ilyas-asmouki/IRIS_HW/Encoders/Docs/FrontPCB.png

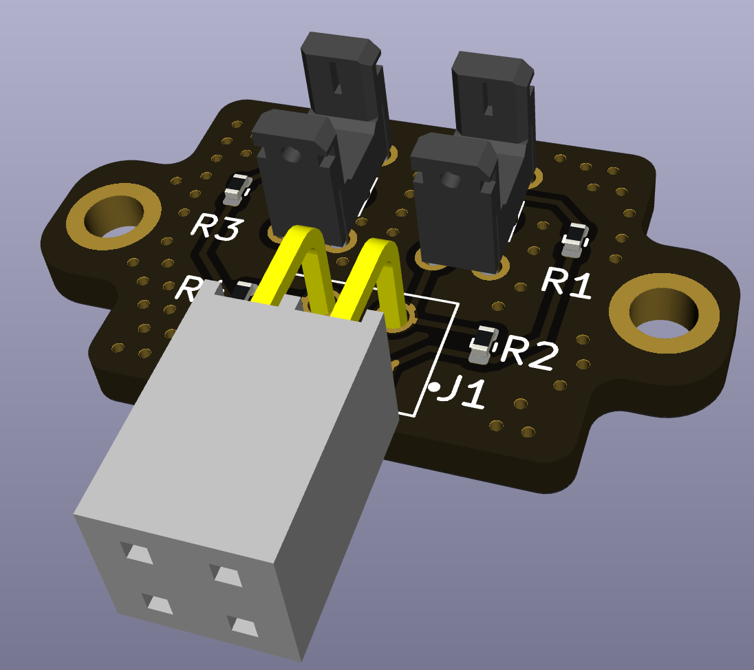
Encoders/Docs/FrontPCB.png
