ilyas-asmouki/IRIS_HW/Encoders/Docs/BackPCB.png

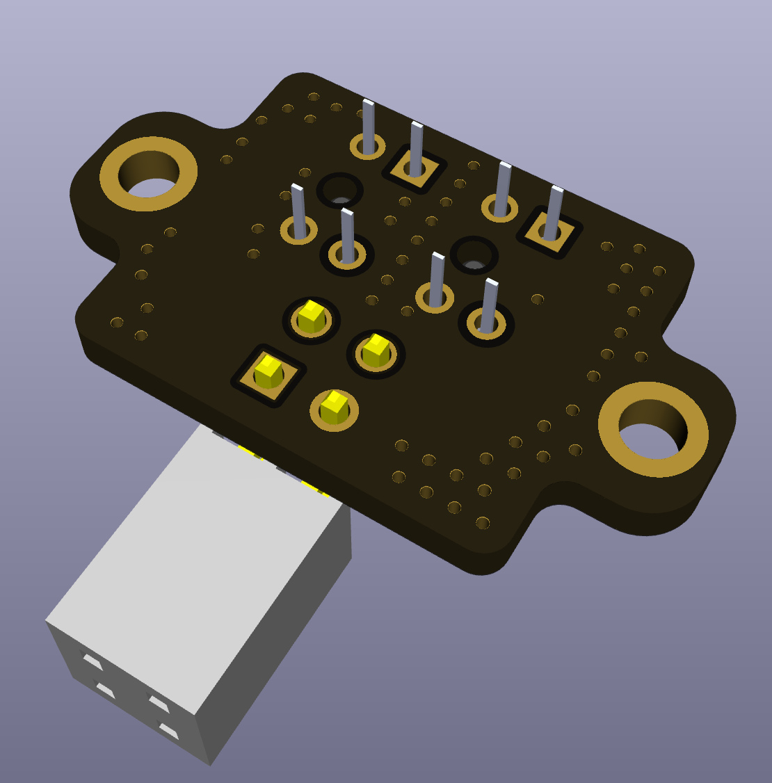
Encoders/Docs/BackPCB.png
