ilyas-asmouki/IRIS_HW/Encoders/Docs/Back.png

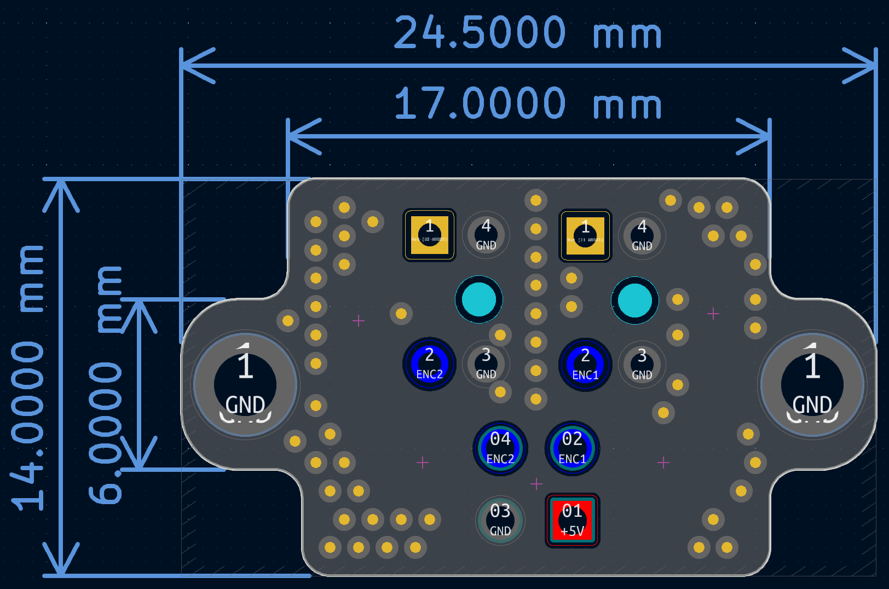
Encoders/Docs/Back.png
