ilyas-asmouki/IRIS_HW/Encoders/Docs/Front.png

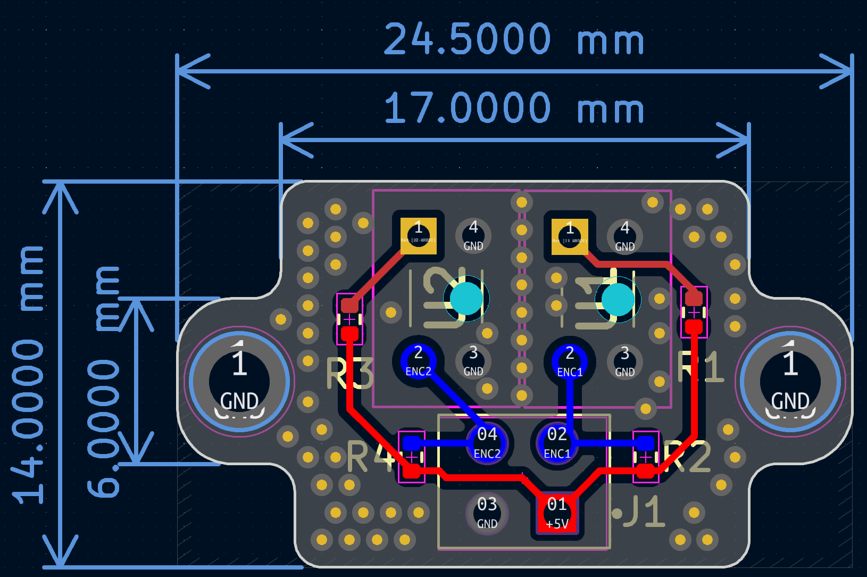
Encoders/Docs/Front.png
