ilyas-asmouki/IRIS_HW/Motor Control Hub/Docs/Back.png

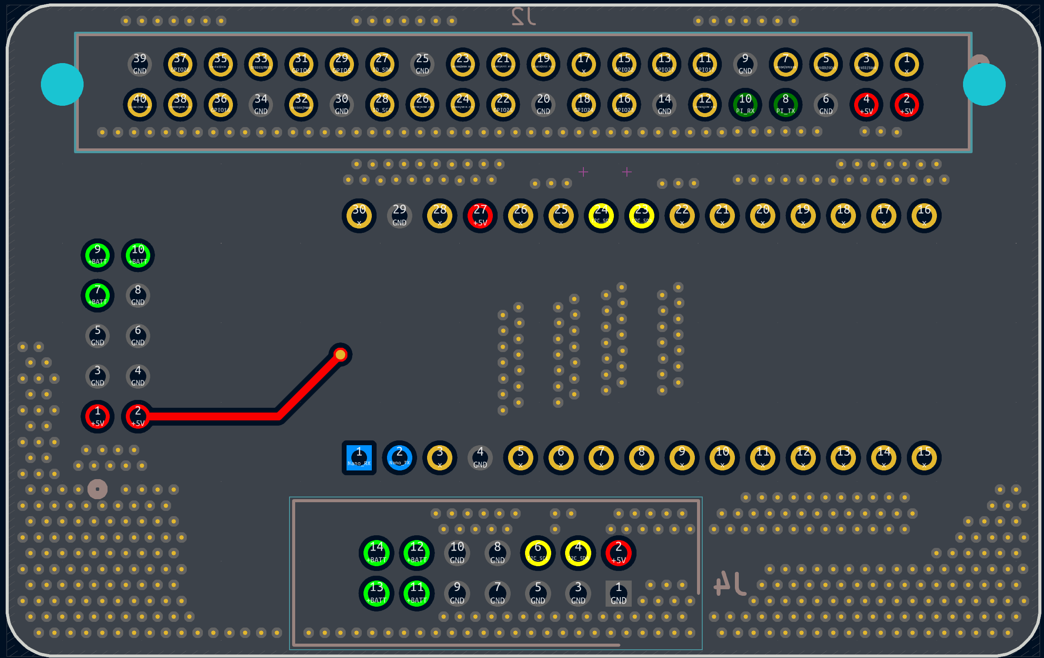
Motor Control Hub/Docs/Back.png
