ilyas-asmouki/IRIS_HW/Motor Control Hub/Docs/BackPCB.png

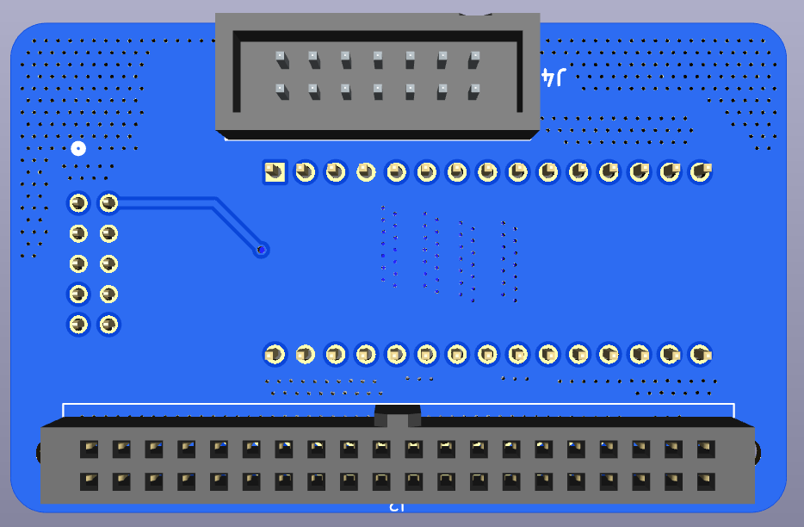
Motor Control Hub/Docs/BackPCB.png
