ilyas-asmouki/IRIS_HW/Motor Control Hub/Docs/Front.png

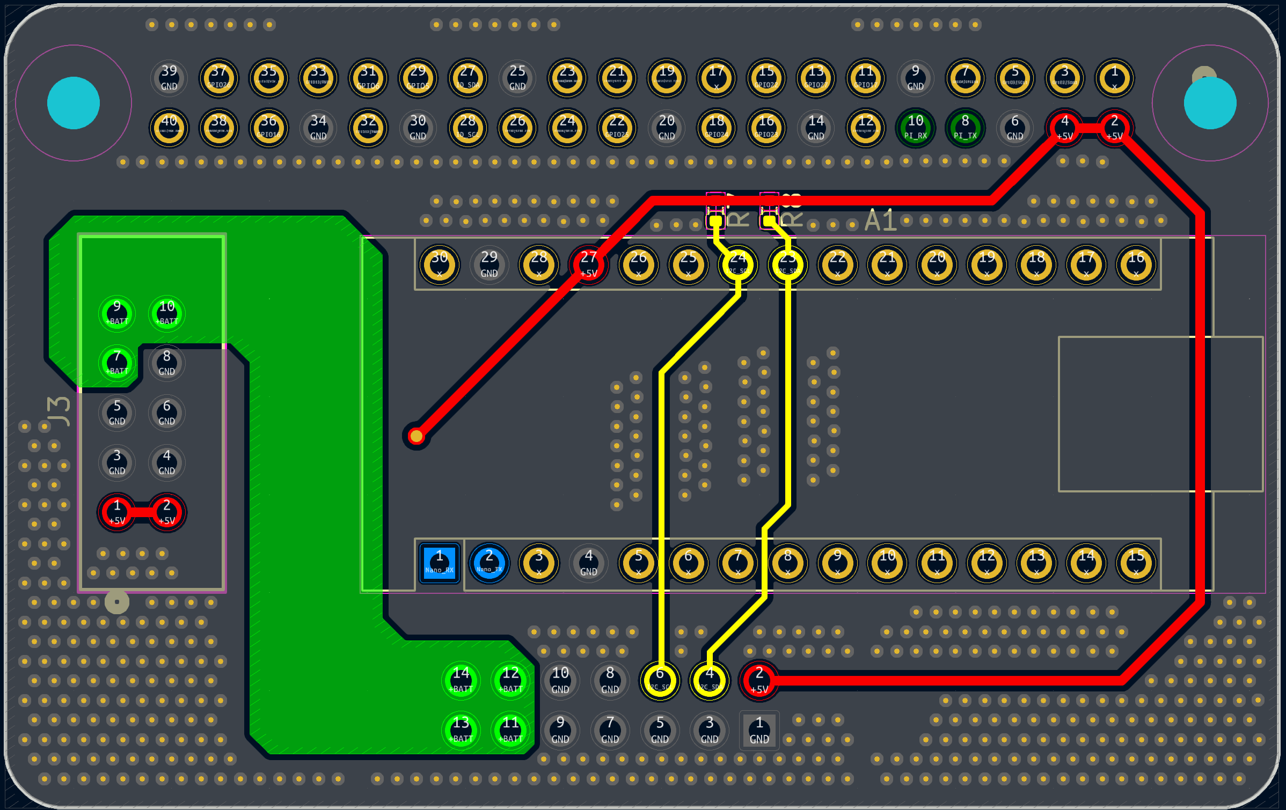
Motor Control Hub/Docs/Front.png
