ilyas-asmouki/IRIS_HW/Motor Control Hub/Docs/FrontPCB.png

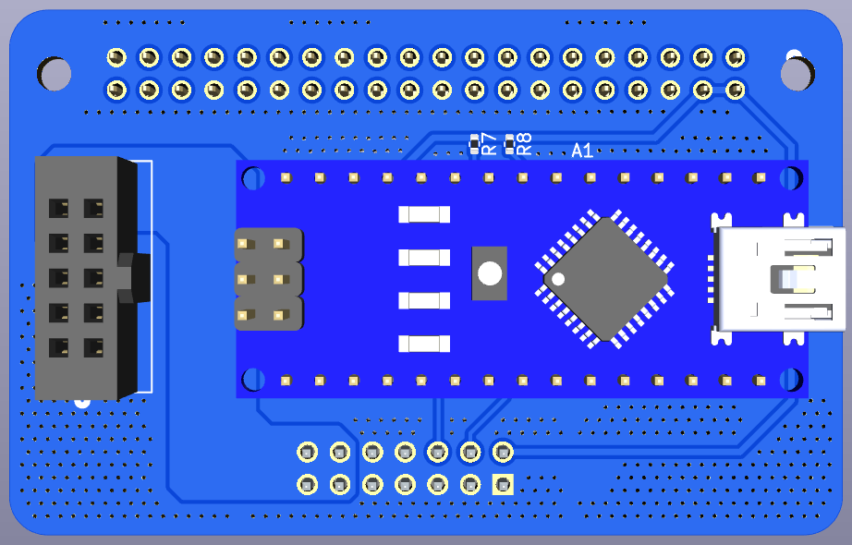
Motor Control Hub/Docs/FrontPCB.png
