ilyas-asmouki/IRIS_HW/Power Supply/Docs/Back.png

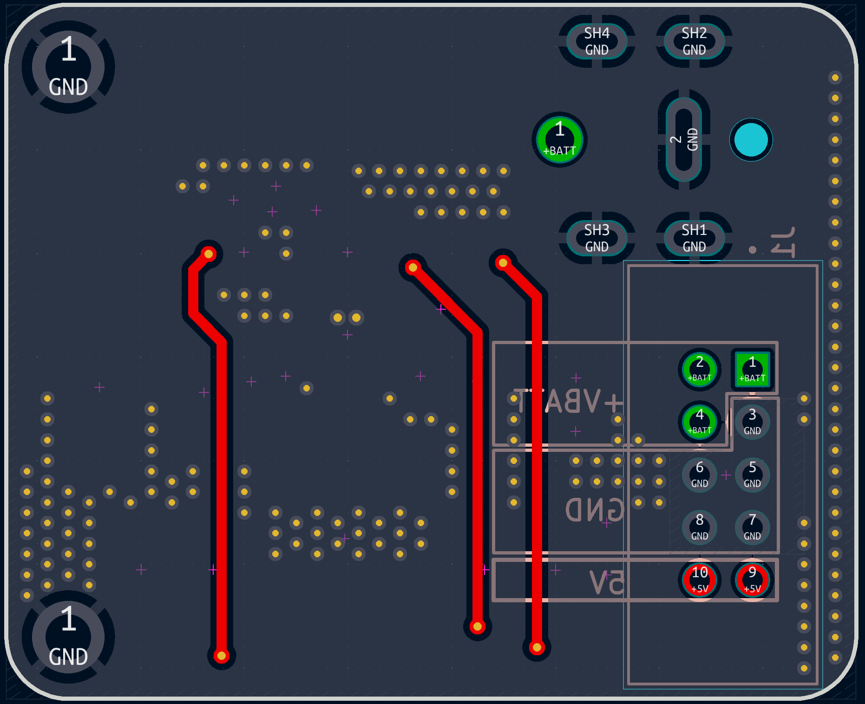
Power Supply/Docs/Back.png
