ilyas-asmouki/IRIS_HW/Power Supply/Docs/BackPCB.png

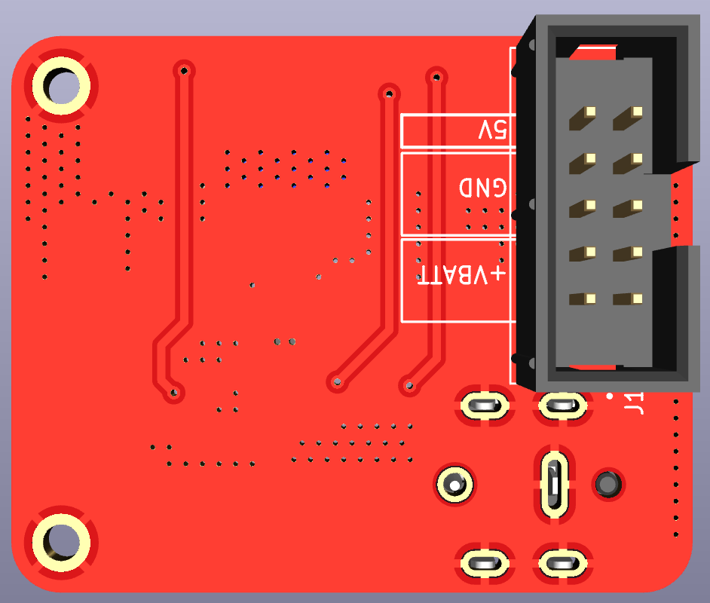
Power Supply/Docs/BackPCB.png
