ilyas-asmouki/IRIS_HW/Power Supply/Docs/Front.png

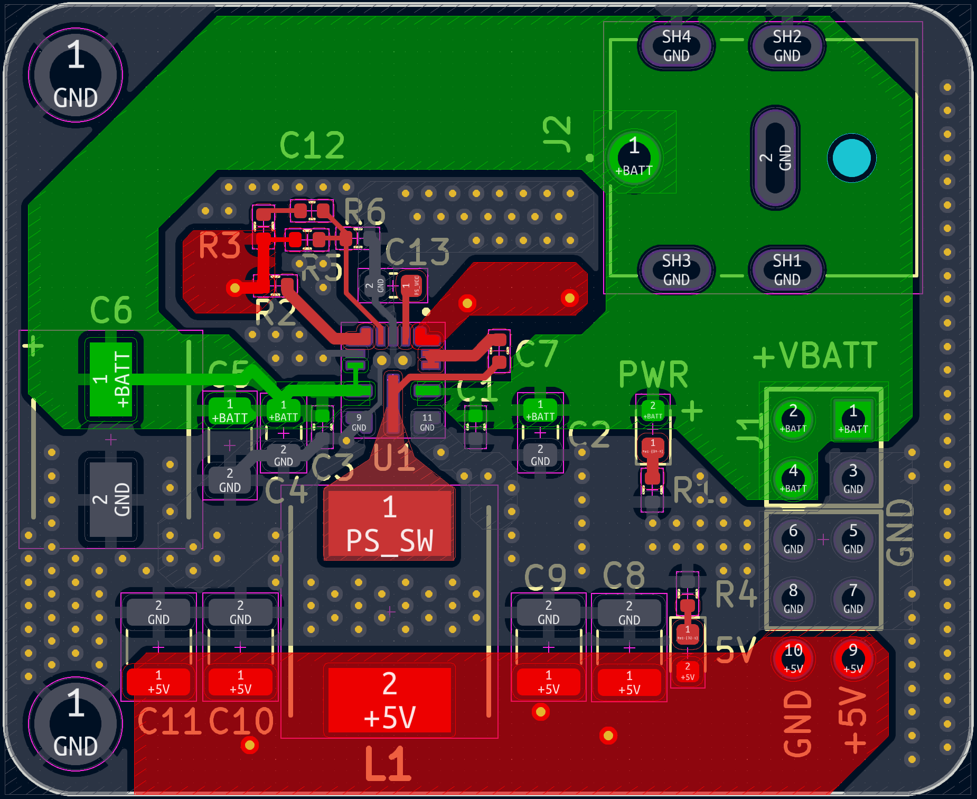
Power Supply/Docs/Front.png
