ilyas-asmouki/IRIS_HW/Power Supply/Docs/FrontPCB.png

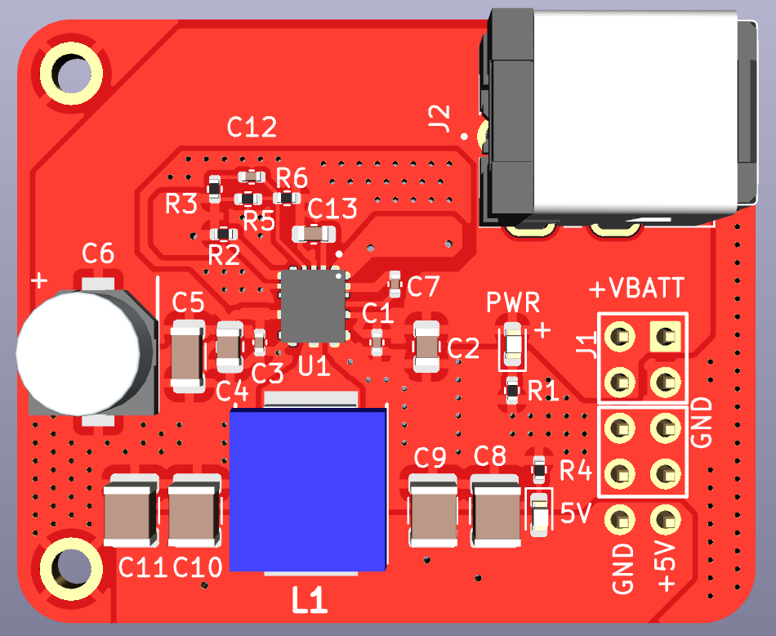
Power Supply/Docs/FrontPCB.png
