ilyas-asmouki/IRIS_HW/Encoders/Docs/Encoders.pdf

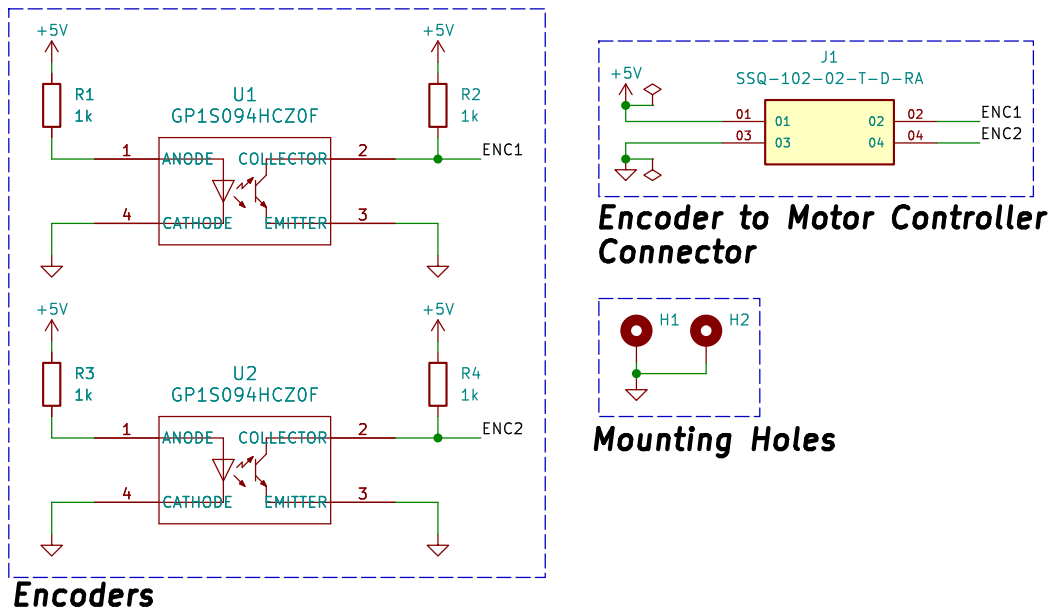
[picture p13: page 1]

Encoder to Motor Controller
Connector
