ilyas-asmouki/IRIS_HW/Motor Control Hub/Docs/Motor Control Hub.pdf

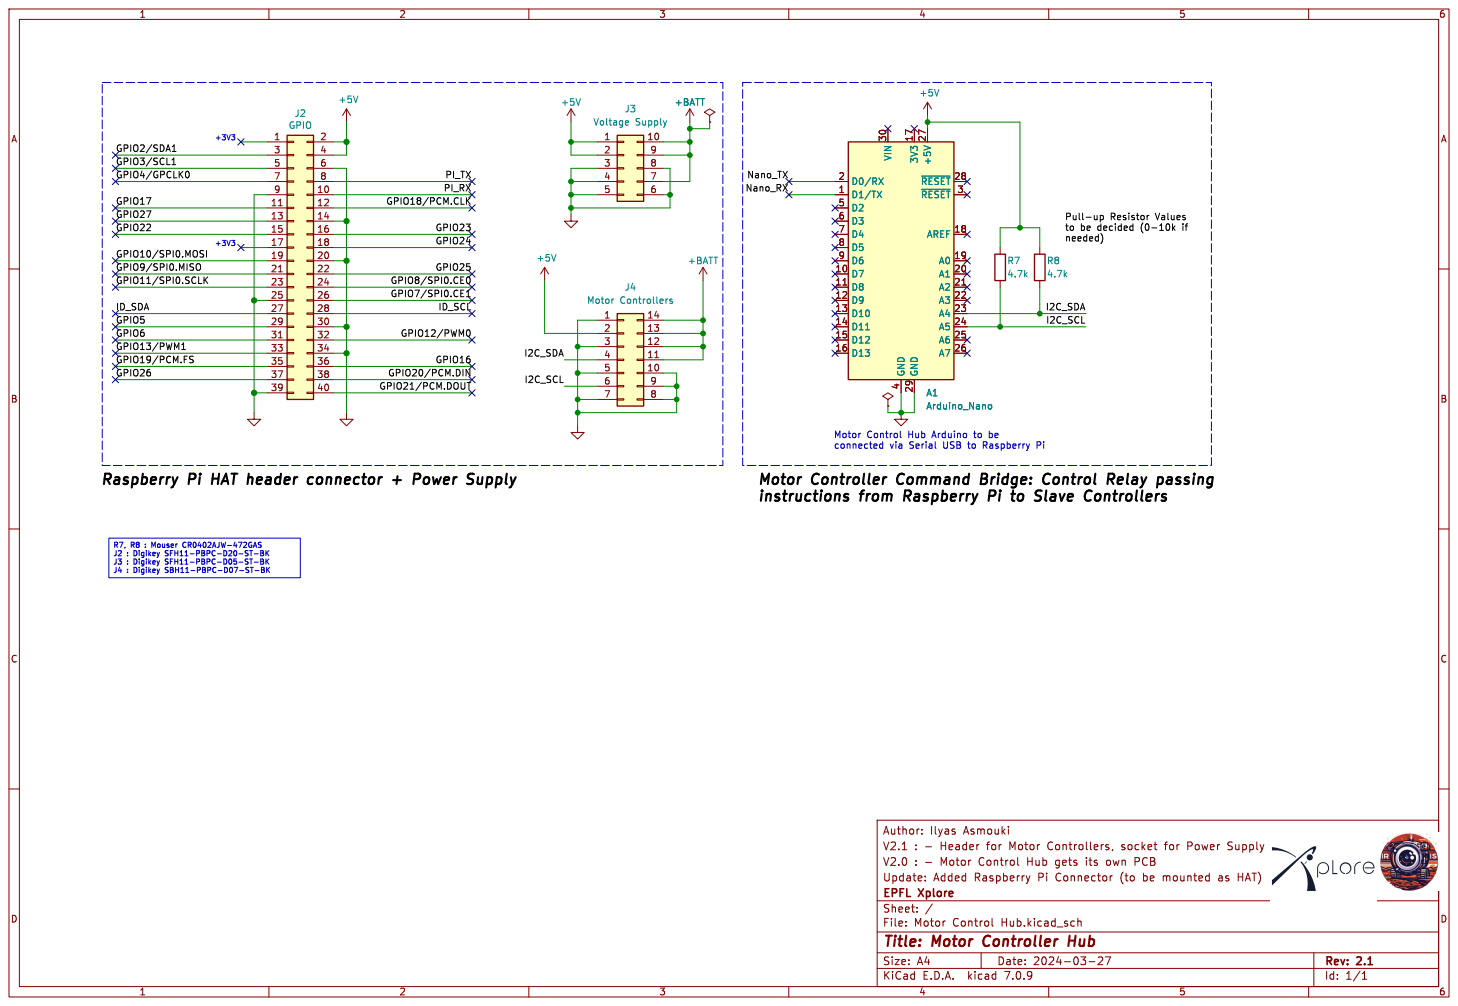
[picture p14: page 1]

I2C_SCL GPIO13/PWM1 GPIO19/PCM.FS GPIO11/SPI0.SCLK GPIO9/SPI0.MISO

Motor Control Hub Arduino to be

instructions from Raspberry Pi to Slave Controllers

J2 : Digikey SFH11-PBPC-D20-ST-BK
J3 : Digikey SFH11-PBPC-D05-ST-BK
J4 : Digikey SBH11-PBPC-D07-ST-BK

Id: 1/1 Title: Motor Controller Hub
