ilyas-asmouki/IRIS_HW/Power Supply/Docs/Power Supply.pdf

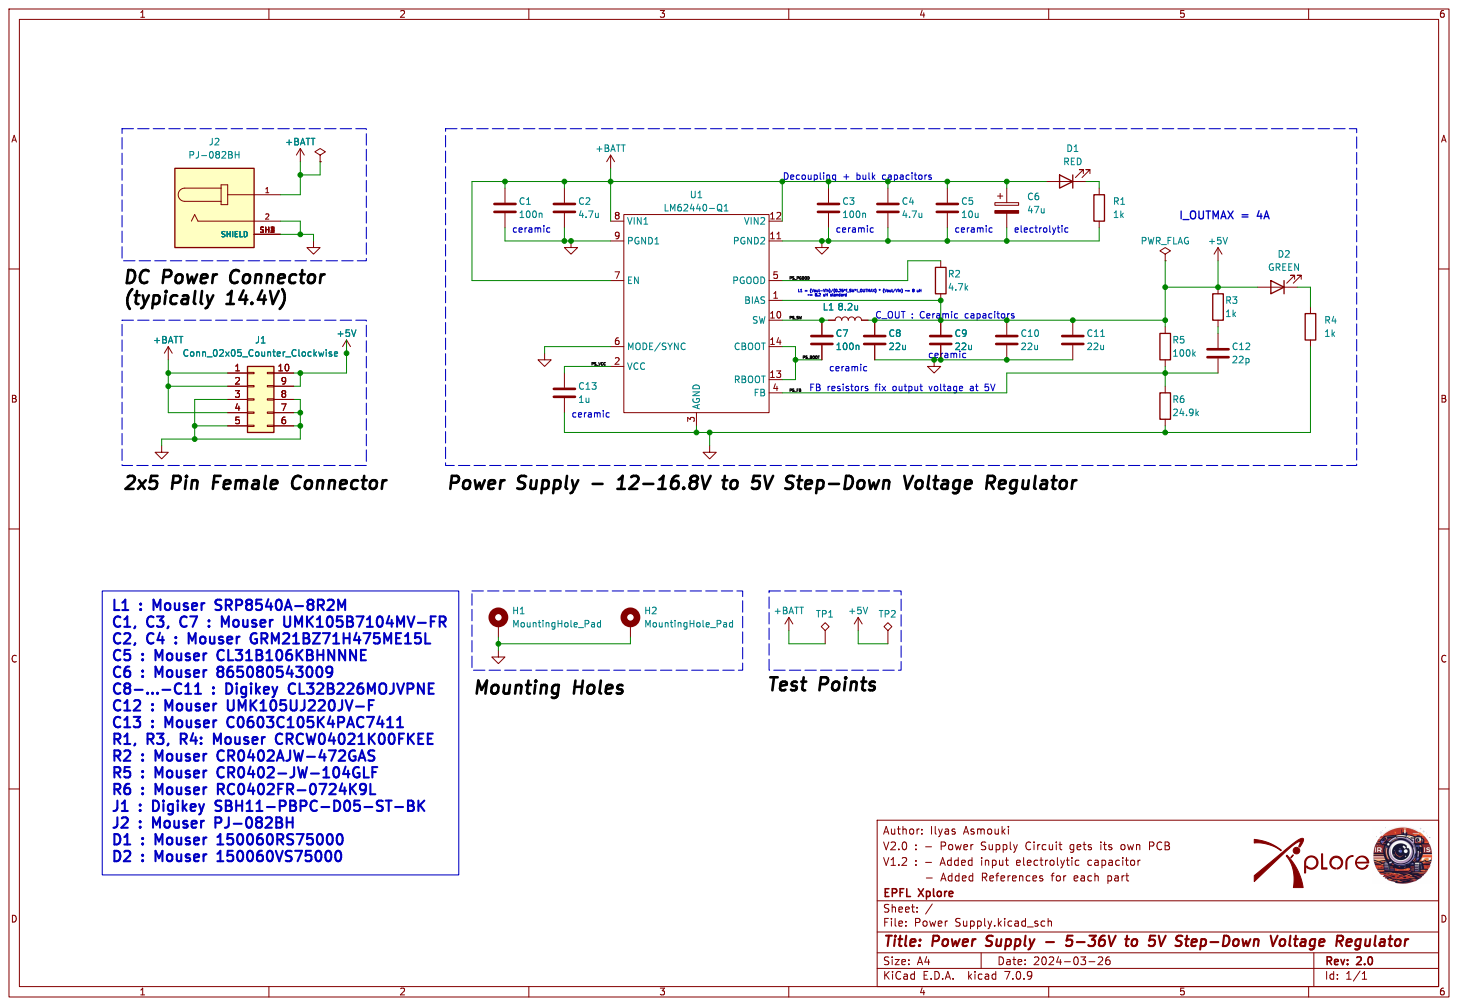
[picture p15: page 1]

3 FB 4 PGOOD 5 MODE/SYNC 6 EN 7 VIN1 8 PGND1 9 U1

ceramic 2x5 Pin Female Connector
