ilyas-asmouki/IRIS_HW/Power Supply/Kicad/Power Supply.kicad_pcb

## KiCad design Power Supply/Kicad/Power Supply.kicad_pcb (2024-05-07)

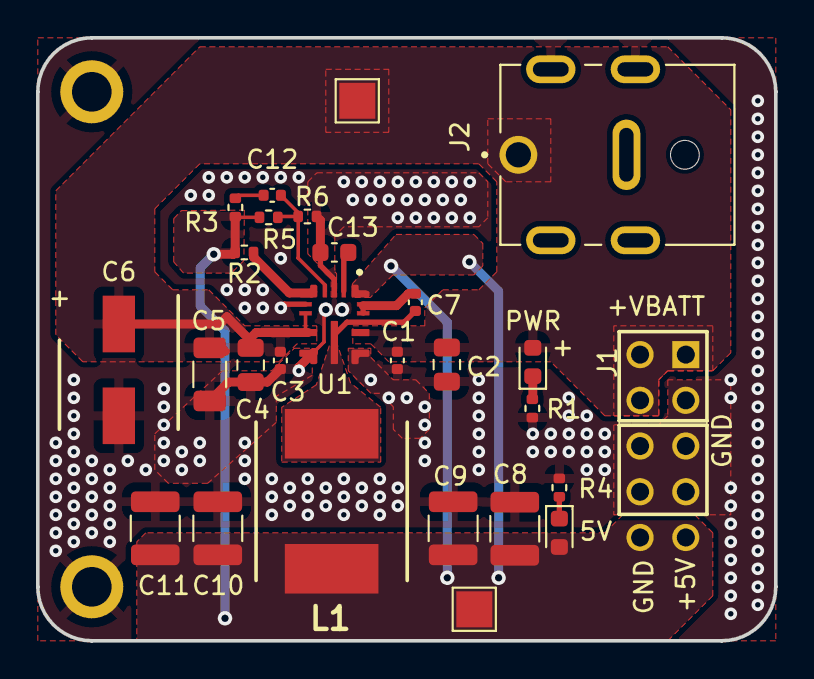
[picture p16: board Power Supply.kicad_pcb from above]

Board: 2 copper layers, 41.0 x 33.5 mm, 29 parts (1 on the bottom side), 11 nets.

Parts:
C1, C3, C7: 100n; C_0402_1005Metric
C2, C4: 4.7u; C_0805_2012Metric
C5: 10u; C_1206_3216Metric
C6: 47u; CAPAE660X550N
C8, C9, C10, C11: 22u; C_1210_3225Metric
C12: 22p; C_0402_1005Metric
C13: 1u; C_0603_1608Metric
D1: RED; LED_0603_1608Metric
D2: GREEN; LED_0603_1608Metric
H1, H2: MountingHole_Pad; MountingHole_2.2mm_M2_ISO7380_Pad
J1: Conn_02x05_Counter_Clockwise; SULLINS_SBH11-PBPC-D05-ST-BK
J2: PJ-082BH; CUI_PJ-082BH
L1: 8.2u; INDPM8884X400N
R1, R3, R4: 1k; R_0402_1005Metric
R2: 4.7k; R_0402_1005Metric
R5: 100k; R_0402_1005Metric
R6: 24.9k; R_0402_1005Metric
TP1, TP2: TestPoint_Alt; TestPoint_Pad_2.0x2.0mm
U1: LM62440-Q1; IC_LM61460AANRJRR

Connections:
+5V: C8.1, C9.1, C10.1, C11.1, D2.2 (A), J1.9, J1.10, L1.2, R2.2, R3.1, R5.1, TP2.1, U1.1 (BIAS)
+BATT: C1.1, C2.1, C3.1, C4.1, C5.1, C6.1, D1.2 (A), J1.1, J1.2, J1.4, J2.1, TP1.1, U1.7 (EN), U1.8 (VIN1), U1.12 (VIN2)
/PS_BOOT: C7.2, U1.13 (RBOOT), U1.14 (CBOOT)
/PS_FB: C12.2, R5.2, R6.1, U1.4 (FB)
/PS_PGOOD: R2.1, U1.5 (PGOOD)
/PS_SW: C7.1, L1.1, U1.10 (SW)
/PS_VCC: C13.1, U1.2 (VCC)
GND: C1.2, C2.2, C3.2, C4.2, C5.2, C6.2, C8.2, C9.2, C10.2, C11.2, C13.2, H1.1, H2.1, J1.3, J1.5, J1.6, J1.7, J1.8, J2.2, J2.SH1 (SHIELD), J2.SH2 (SHIELD), J2.SH3 (SHIELD), J2.SH4 (SHIELD), R1.2, R4.2, R6.2, U1.3 (AGND), U1.6 (MODE/SYNC), U1.9 (PGND1), U1.11 (PGND2)
unnamed: C12.1, R3.2
unnamed: D1.1 (K), R1.1
unnamed: D2.1 (K), R4.1
