ilyas-asmouki/IRIS_HW/Motor Controllers/KiCad/Motor Controllers.kicad_pcb

## KiCad design Motor Controllers/KiCad/Motor Controllers.kicad_pcb (2024-05-07)

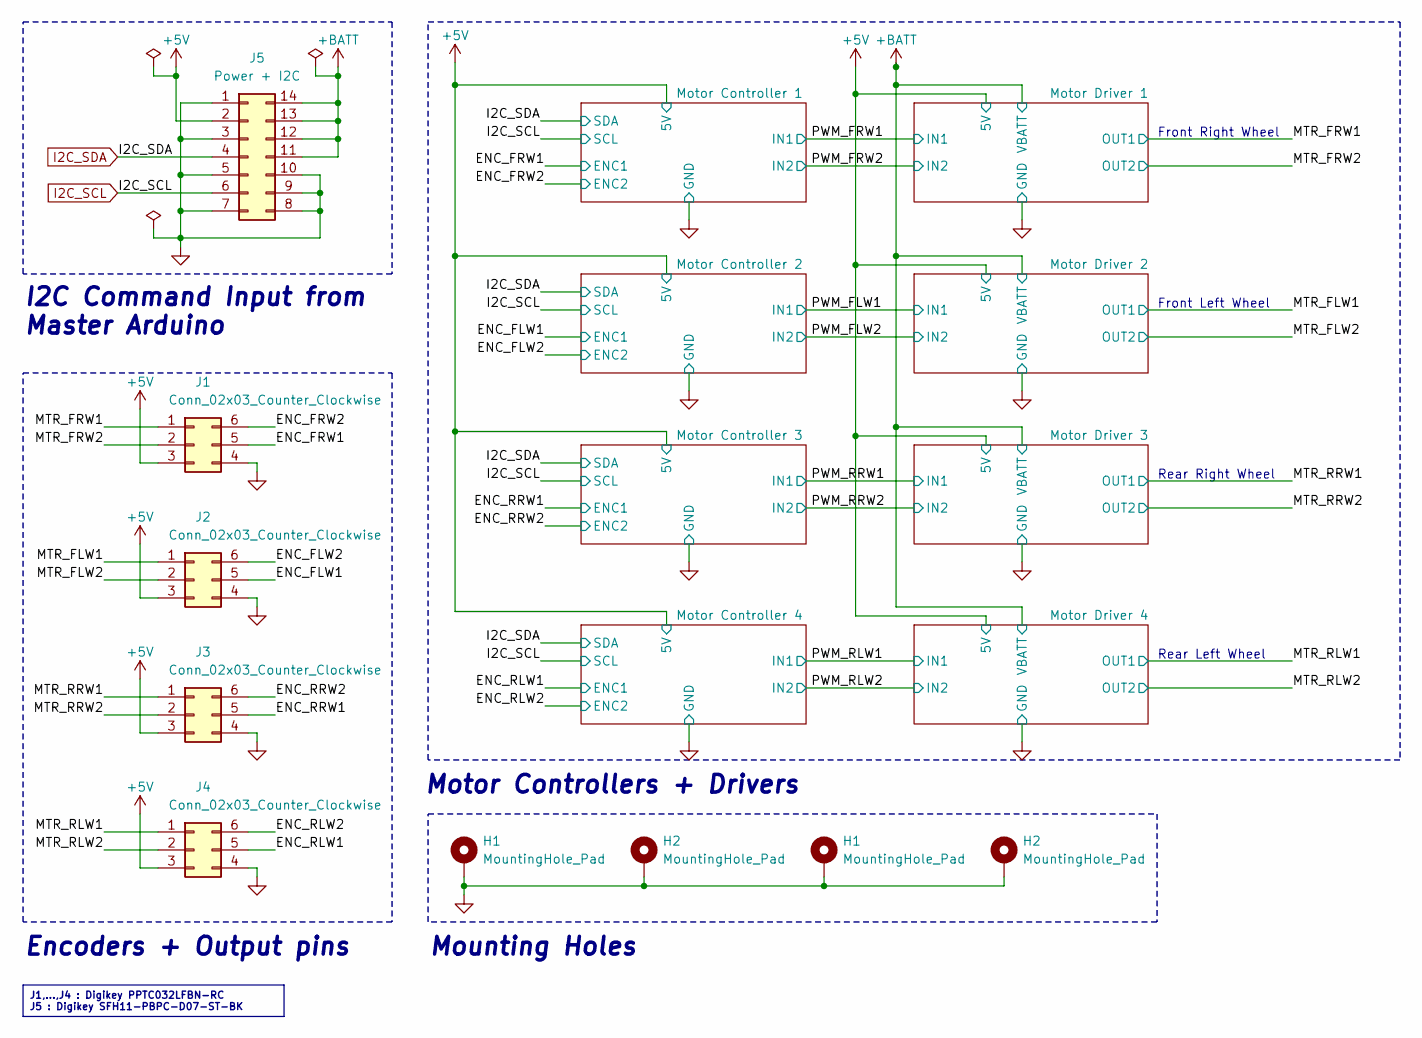
[picture p17: schematic Motor Controllers.kicad_sch]

Parts:
H1, H2: MountingHole_Pad; MountingHole_2.2mm_M2_ISO7380_Pad
J1, J2, J3, J4: Conn_02x03_Counter_Clockwise; SULLINS_PPTC032LFBN-RC
J5: Power + I2C; SULLINS_SFH11-PBPC-D07-ST-BK

Connections:
+5V: J1.3, J2.3, J3.3, J4.3, J5.2; also elsewhere on the board
+BATT: J5.11, J5.12, J5.13, J5.14; also elsewhere on the board
/ENC_FLW1: J2.5; also elsewhere on the board
/ENC_FLW2: J2.6; also elsewhere on the board
/ENC_FRW1: J1.5; also elsewhere on the board
/ENC_FRW2: J1.6; also elsewhere on the board
/ENC_RLW1: J4.5; also elsewhere on the board
/ENC_RLW2: J4.6; also elsewhere on the board
/ENC_RRW1: J3.5; also elsewhere on the board
/ENC_RRW2: J3.6; also elsewhere on the board
/MTR_FLW1: J2.1; also elsewhere on the board
/MTR_FLW2: J2.2; also elsewhere on the board
/MTR_FRW1: J1.1; also elsewhere on the board
/MTR_FRW2: J1.2; also elsewhere on the board
/MTR_RLW1: J4.1; also elsewhere on the board
/MTR_RLW2: J4.2; also elsewhere on the board
/MTR_RRW1: J3.1; also elsewhere on the board
/MTR_RRW2: J3.2; also elsewhere on the board
GND: H1.1, H2.1, J1.4, J2.4, J3.4, J4.4, J5.1, J5.3, J5.5, J5.7, J5.8, J5.9, J5.10; also elsewhere on the board
I2C_SCL: J5.6; also elsewhere on the board
I2C_SDA: J5.4; also elsewhere on the board

Parts of its further copies:
H3, H4: MountingHole_Pad; MountingHole_2.2mm_M2_ISO7380_Pad

Connections of its further copies:
GND: H3.1, H4.1; also elsewhere on the board

Notes on the sheet:
J1,...,J4 : Digikey PPTC032LFBN-RC J5 : Digikey SFH11-PBPC-D07-ST-BK
Mounting Holes
Rear Right Wheel
Rear Left Wheel
I2C Command Input from Master Arduino
Motor Controllers + Drivers
Front Left Wheel
Encoders + Output pins
Front Right Wheel

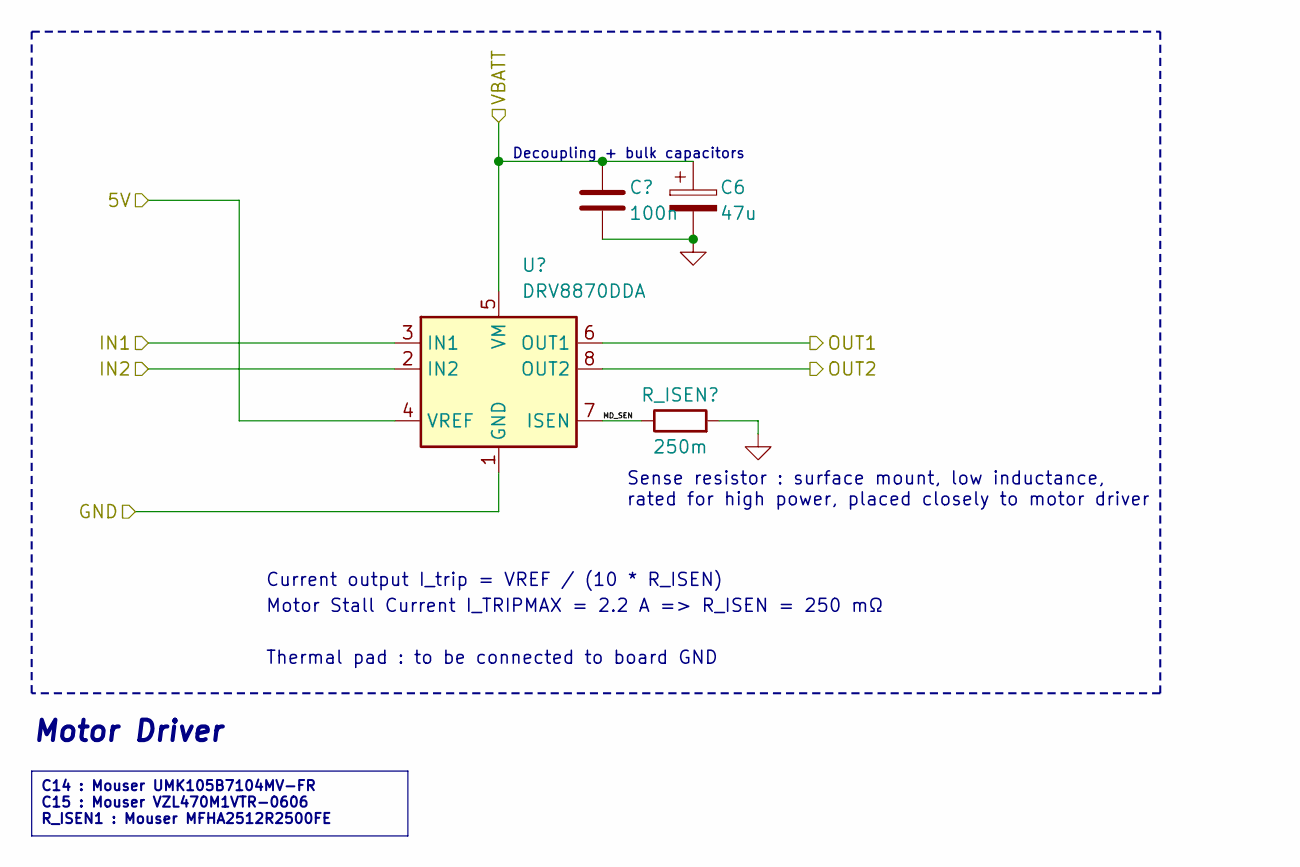
[picture p18: schematic motordriver.kicad_sch]

Parts:
C6: 47u; CAPAE660X550N
C14: 100n; C_0402_1005Metric
R_ISEN1: 250m; R_2512_6332Metric
U2: DRV8870DDA; Texas_HTSOP-8-1EP_3.9x4.9mm_P1.27mm_EP2.95x4.9mm_Mask2.4x3.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

Connections:
+5V: U2.4 (VREF); also elsewhere on the board
+BATT: C14.1, U2.5 (VM); also elsewhere on the board
/MTR_FLW1: U2.6 (OUT1); also elsewhere on the board
/MTR_FLW2: U2.8 (OUT2); also elsewhere on the board
/PWM_FLW1: U2.3 (IN1); also elsewhere on the board
/PWM_FLW2: U2.2 (IN2); also elsewhere on the board
GND: C14.2, R_ISEN1.2, U2.1 (GND), U2.9 (GND); also elsewhere on the board

Parts of its further copies:
C15, C17, C19, C21: 47u; CAPAE660X550N
C16, C18, C20: 100n; C_0402_1005Metric
R_ISEN2, R_ISEN3, R_ISEN4: 250m; R_2512_6332Metric
U1, U3, U4: DRV8870DDA; Texas_HTSOP-8-1EP_3.9x4.9mm_P1.27mm_EP2.95x4.9mm_Mask2.4x3.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

Connections of its further copies:
+5V: U1.4 (VREF), U3.4 (VREF), U4.4 (VREF); also elsewhere on the board
+BATT: C15.1, C16.1, C17.1, C18.1, C19.1, C20.1, C21.1, U1.5 (VM), U3.5 (VM), U4.5 (VM); also elsewhere on the board
/MTR_FRW1: U1.6 (OUT1); also elsewhere on the board
/MTR_FRW2: U1.8 (OUT2); also elsewhere on the board
/MTR_RLW1: U4.6 (OUT1); also elsewhere on the board
/MTR_RLW2: U4.8 (OUT2); also elsewhere on the board
/MTR_RRW1: U3.6 (OUT1); also elsewhere on the board
/MTR_RRW2: U3.8 (OUT2); also elsewhere on the board
/Motor Driver 3/MD_SEN: R_ISEN3.1, U3.7 (ISEN)
/Motor Driver 4/MD_SEN: R_ISEN4.1, U4.7 (ISEN)
/PWM_FRW1: U1.3 (IN1); also elsewhere on the board
/PWM_FRW2: U1.2 (IN2); also elsewhere on the board
/PWM_RLW1: U4.3 (IN1); also elsewhere on the board
/PWM_RLW2: U4.2 (IN2); also elsewhere on the board
/PWM_RRW1: U3.3 (IN1); also elsewhere on the board
/PWM_RRW2: U3.2 (IN2); also elsewhere on the board
GND: C15.2, C16.2, C17.2, C18.2, C19.2, C20.2, C21.2, R_ISEN2.2, R_ISEN3.2, R_ISEN4.2, U1.1 (GND), U1.9 (GND), U3.1 (GND), U3.9 (GND), U4.1 (GND), U4.9 (GND); also elsewhere on the board

Notes on the sheet:
Sense resistor : surface mount, low inductance, rated for high power, placed closely to motor driver
C14 : Mouser UMK105B7104MV-FR C15 : Mouser VZL470M1VTR-0606 R_ISEN1 : Mouser MFHA2512R2500FE
Decoupling + bulk capacitors
Current output I_trip = VREF / (10 * R_ISEN)
Motor Stall Current I_TRIPMAX = 2.2 A => R_ISEN = 250 mΩ
Motor Driver
Thermal pad : to be connected to board GND

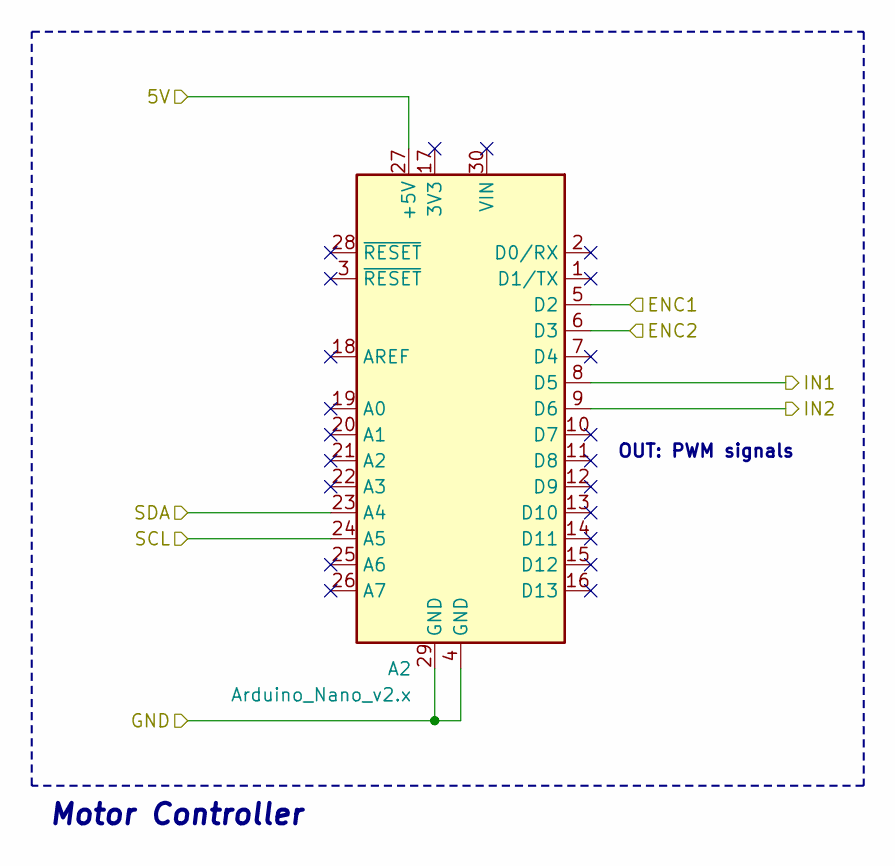
[picture p19: schematic motorcontroller.kicad_sch]

Parts:
A2: Arduino_Nano_v2.x; Arduino_Nano

Connections:
+5V: A2.27 (+5V); also elsewhere on the board
/ENC_FLW1: A2.5 (D2); also elsewhere on the board
/ENC_FLW2: A2.6 (D3); also elsewhere on the board
/PWM_FLW1: A2.8 (D5); also elsewhere on the board
/PWM_FLW2: A2.9 (D6); also elsewhere on the board
GND: A2.4 (GND), A2.29 (GND); also elsewhere on the board
I2C_SCL: A2.24 (A5); also elsewhere on the board
I2C_SDA: A2.23 (A4); also elsewhere on the board

Parts of its further copies:
A1, A3, A4: Arduino_Nano_v2.x; Arduino_Nano

Connections of its further copies:
+5V: A1.27 (+5V), A3.27 (+5V), A4.27 (+5V); also elsewhere on the board
/ENC_FRW1: A1.5 (D2); also elsewhere on the board
/ENC_FRW2: A1.6 (D3); also elsewhere on the board
/ENC_RLW1: A4.5 (D2); also elsewhere on the board
/ENC_RLW2: A4.6 (D3); also elsewhere on the board
/ENC_RRW1: A3.5 (D2); also elsewhere on the board
/ENC_RRW2: A3.6 (D3); also elsewhere on the board
/PWM_FRW1: A1.8 (D5); also elsewhere on the board
/PWM_FRW2: A1.9 (D6); also elsewhere on the board
/PWM_RLW1: A4.8 (D5); also elsewhere on the board
/PWM_RLW2: A4.9 (D6); also elsewhere on the board
/PWM_RRW1: A3.8 (D5); also elsewhere on the board
/PWM_RRW2: A3.9 (D6); also elsewhere on the board
GND: A1.4 (GND), A1.29 (GND), A3.4 (GND), A3.29 (GND), A4.4 (GND), A4.29 (GND); also elsewhere on the board
I2C_SCL: A1.24 (A5), A3.24 (A5), A4.24 (A5); also elsewhere on the board
I2C_SDA: A1.23 (A4), A3.23 (A4), A4.23 (A4); also elsewhere on the board

Notes on the sheet:
Motor Controller
OUT: PWM signals

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
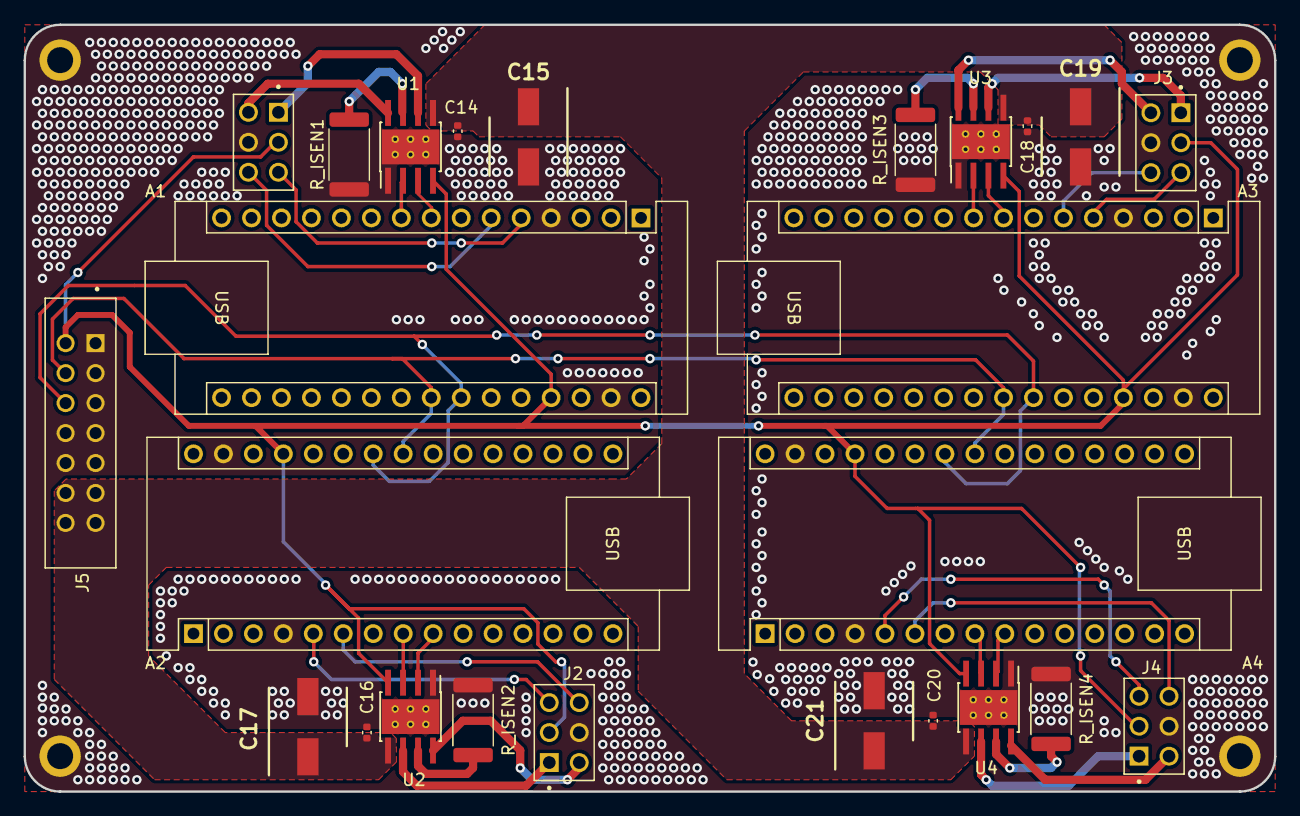
[picture p20: board Motor Controllers.kicad_pcb from above]

Board: 2 copper layers, 106.0 x 65.0 mm, 29 parts (0 on the bottom side), 33 nets.
