ilyas-asmouki/IRIS_HW/Encoders/Kicad/Encoders.kicad_pcb

## KiCad design Encoders/Kicad/Encoders.kicad_pcb (2024-05-07)

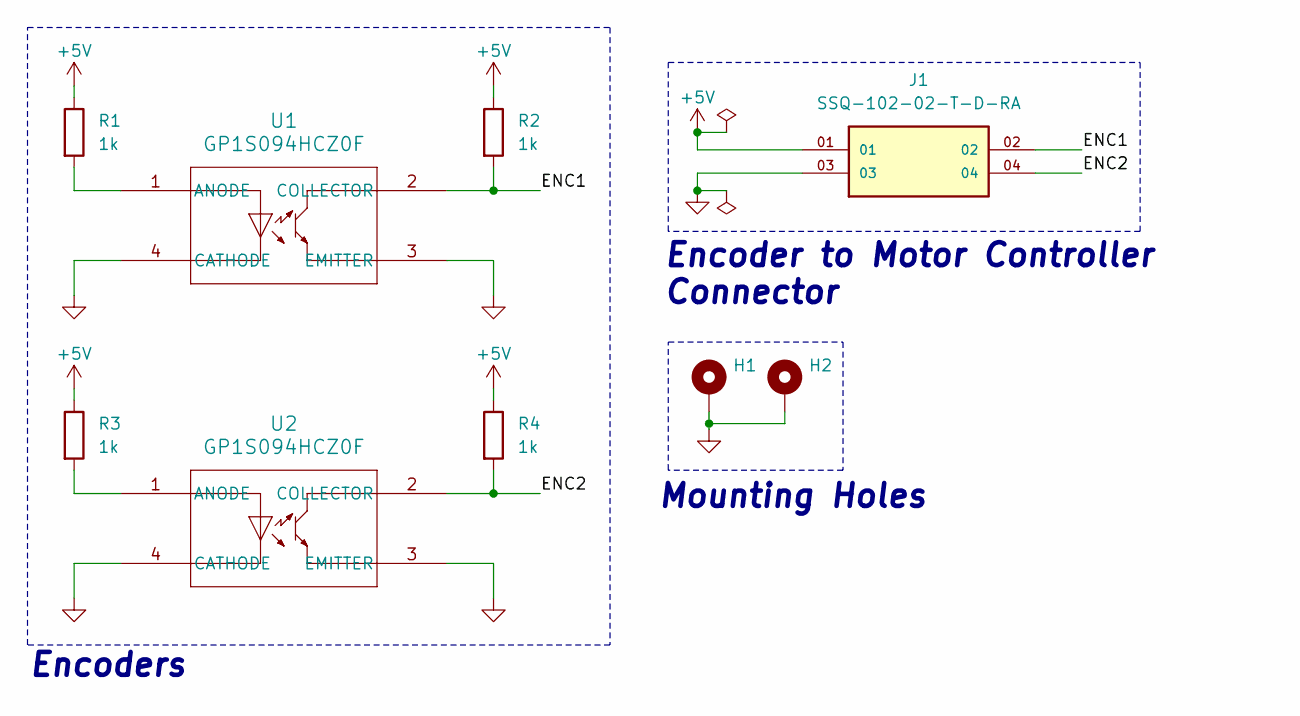
[picture p21: schematic Encoders.kicad_sch]

Parts:
H1, H2: MountingHole_Pad; MountingHole_2.2mm_M2_ISO7380_Pad_TopBottom
J1: SSQ-102-02-T-D-RA; SAMTEC_SSQ-102-02-T-D-RA; PARTREV R
R1, R2, R3, R4: 1k; R_0402_1005Metric
U1, U2: GP1S094HCZ0F

Connections:
+5V: J1.01, R1.1, R2.1, R3.1, R4.1
/ENC1: J1.02, R2.2, U1.2 (COLLECTOR)
/ENC2: J1.04, R4.2, U2.2 (COLLECTOR)
GND: H1.1, H2.1, J1.03, U1.3 (EMITTER), U1.4 (CATHODE), U2.3 (EMITTER), U2.4 (CATHODE)
unnamed: R1.2, U1.1 (ANODE)
unnamed: R3.2, U2.1 (ANODE)

Notes on the sheet:
Encoders
Encoder to Motor Controller Connector
Mounting Holes

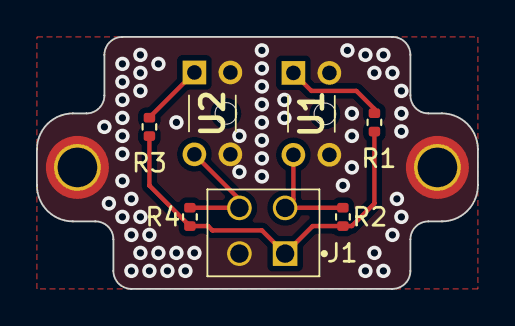
[picture p22: board Encoders.kicad_pcb from above]

Board: 2 copper layers, 24.5 x 14.0 mm, 9 parts (0 on the bottom side), 6 nets.
