ilyas-asmouki/IRIS_HW/Motor Control Hub/KiCad/Motor Control Hub.kicad_pcb

## KiCad design Motor Control Hub/KiCad/Motor Control Hub.kicad_pcb (2024-05-07)

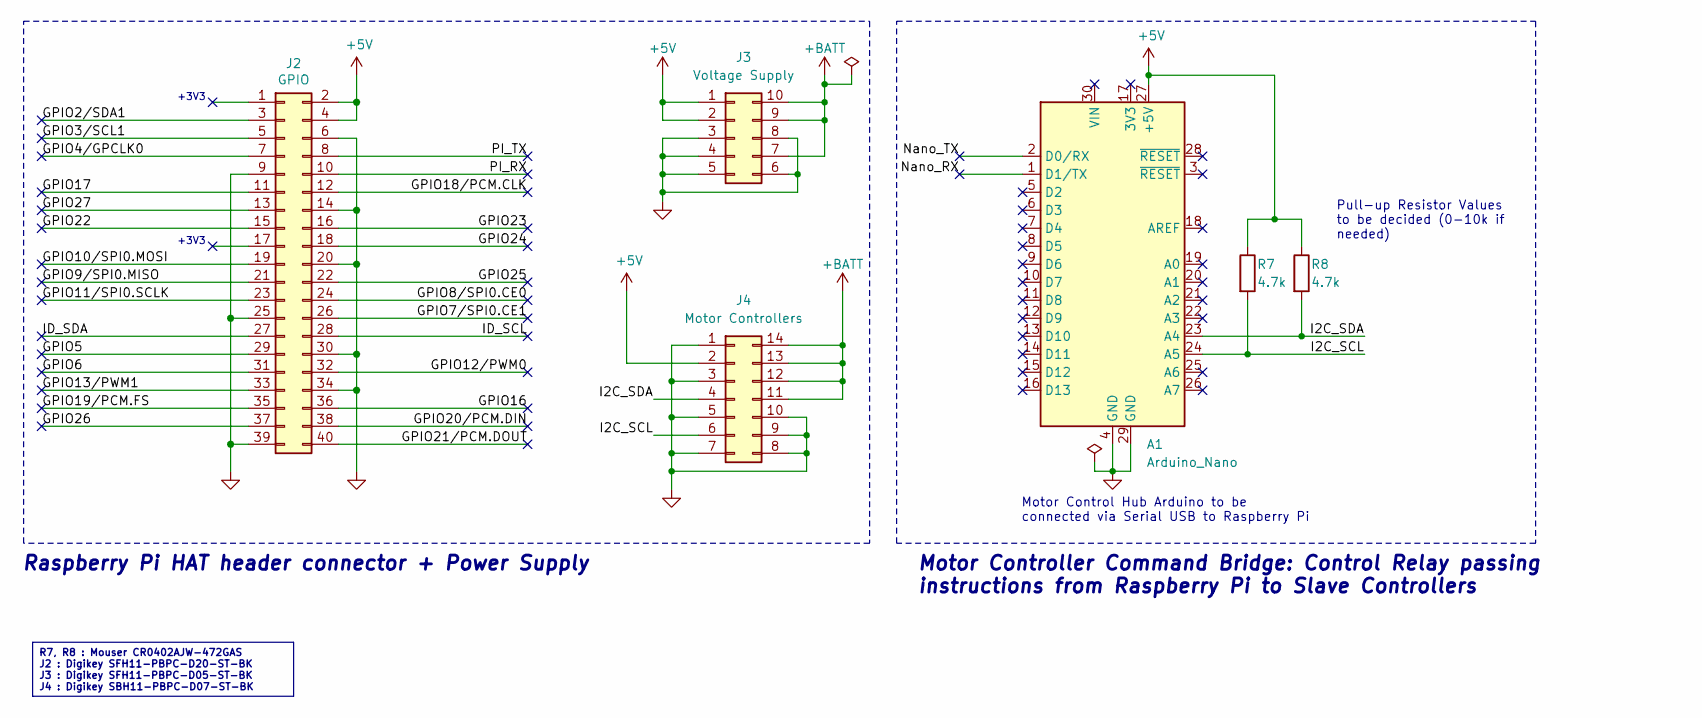
[picture p23: schematic Motor Control Hub.kicad_sch, Motor Controller Hub]

Parts:
A1: Arduino_Nano
J2: GPIO; CONN_SFH11-PBPC-D20-ST-BK_SUL
J3: Voltage Supply; CONN_SFH11-xxxC-D05-ST-XX_SUL
J4: Motor Controllers; SHDR14W64P254_2X7_2528X910X910P
R7, R8: 4.7k; R_0402_1005Metric

Connections:
+5V: A1.27 (+5V), J2.2, J2.4, J3.1, J3.2, J4.2, R7.1, R8.1
+BATT: J3.7, J3.9, J3.10, J4.11, J4.12, J4.13, J4.14
/GPIO2/SDA1: J2.3
/GPIO3/SCL1: J2.5
/GPIO4/GPCLK0: J2.7
/GPIO5: J2.29
/GPIO6: J2.31
/GPIO7/SPI0.CE1: J2.26
/GPIO8/SPI0.CE0: J2.24
/GPIO9/SPI0.MISO: J2.21
/GPIO10/SPI0.MOSI: J2.19
/GPIO11/SPI0.SCLK: J2.23
/GPIO12/PWM0: J2.32
/GPIO13/PWM1: J2.33
/GPIO16: J2.36
/GPIO17: J2.11
/GPIO18/PCM.CLK: J2.12
/GPIO19/PCM.FS: J2.35
/GPIO20/PCM.DIN: J2.38
/GPIO21/PCM.DOUT: J2.40
/GPIO22: J2.15
/GPIO23: J2.16
/GPIO24: J2.18
/GPIO25: J2.22
/GPIO26: J2.37
/GPIO27: J2.13
/I2C_SCL: A1.24 (A5), J4.6, R7.2
/I2C_SDA: A1.23 (A4), J4.4, R8.2
/ID_SCL: J2.28
/ID_SDA: J2.27
/Nano_RX: A1.1 (D1/TX)
/Nano_TX: A1.2 (D0/RX)
/PI_RX: J2.10
/PI_TX: J2.8
GND: A1.4 (GND), A1.29 (GND), J2.6, J2.9, J2.14, J2.20, J2.25, J2.30, J2.34, J2.39, J3.3, J3.4, J3.5, J3.6, J3.8, J4.1, J4.3, J4.5, J4.7, J4.8, J4.9, J4.10

Notes on the sheet:
Motor Control Hub Arduino to be connected via Serial USB to Raspberry Pi
R7, R8 : Mouser CR0402AJW-472GAS J2 : Digikey SFH11-PBPC-D20-ST-BK J3 : Digikey SFH11-PBPC-D05-ST-BK J4 : Digikey SBH11-PBPC-D07-ST-BK
Pull-up Resistor Values to be decided (0-10k if needed)
Motor Controller Command Bridge: Control Relay passing instructions from Raspberry Pi to Slave Controllers
Raspberry Pi HAT header connector + Power Supply
+3V3

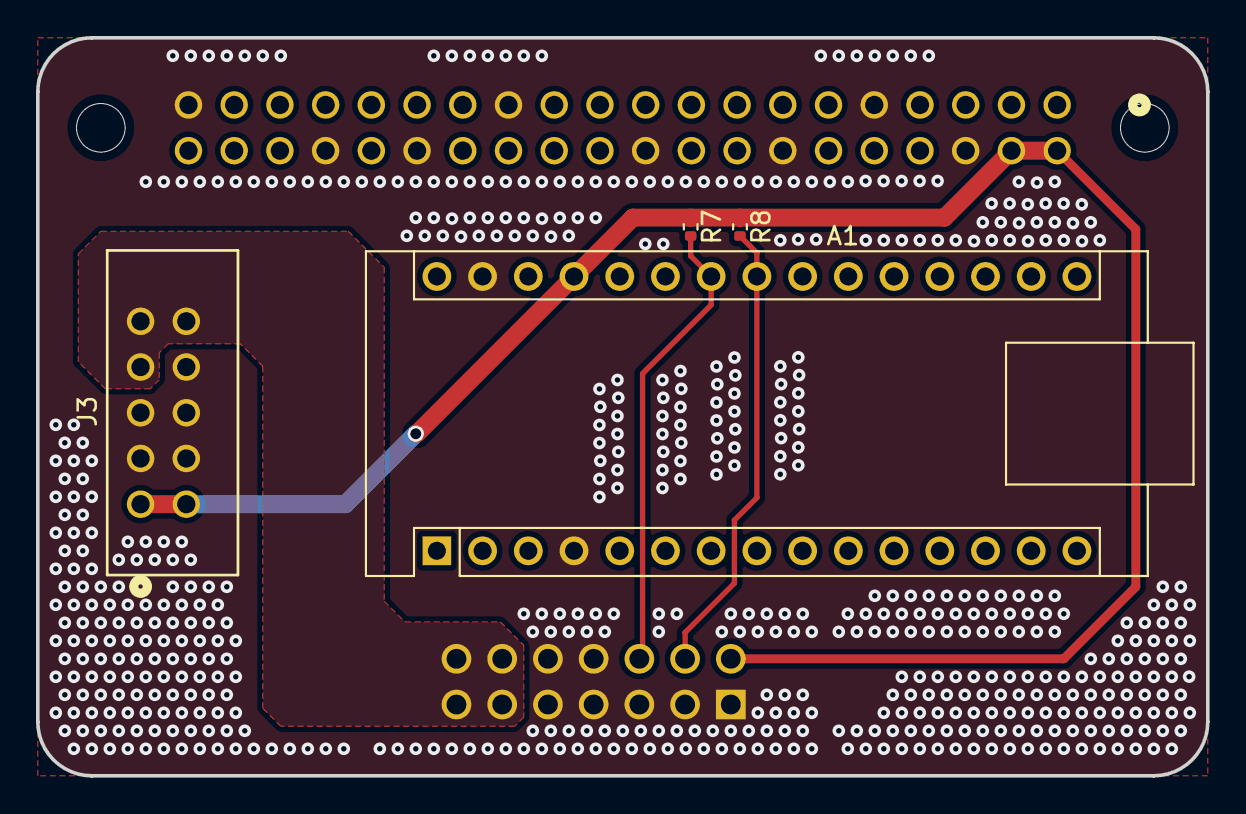
[picture p24: board Motor Control Hub.kicad_pcb from above]

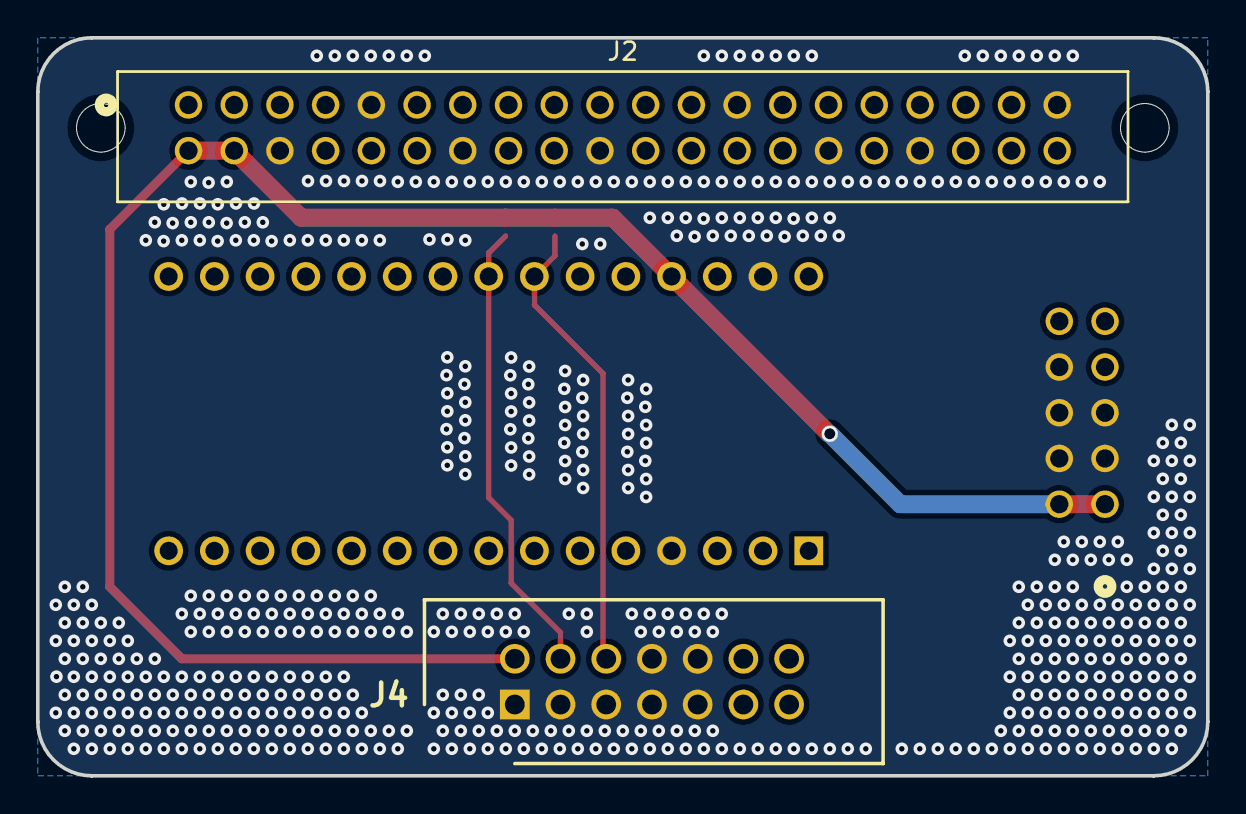
[picture p25: board Motor Control Hub.kicad_pcb from below]

Board: 2 copper layers, 65.0 x 41.0 mm, 8 parts (2 on the bottom side), 5 nets.

Other parts of the board:
MH1, MH2: MountingHole_2.7mm_M2.5
