ilyas-asmouki/IRIS_HW/(commit log)

2024-04-20 First Commit of Motor Control Hub
    [Motor Control Hub.kicad_pcb, Motor Control Hub.kicad_sch, Power Supply.kicad_pcb, Power Supply.kicad_sch]
2024-04-20 First Commit of Motor Controllers
    [Motor Controllers.kicad_pcb, Motor Controllers.kicad_sch, motorcontroller.kicad_sch, motordriver.kicad_sch]
2024-05-07 added encoders, slightly adjusted copper tracks
    [Encoders.kicad_pcb, Encoders.kicad_sch, Motor Control Hub.kicad_pcb, Motor Control Hub.kicad_sch, Motor Controllers.kicad_pcb, Motor Controllers.kicad_sch, Power Supply.kicad_pcb, Power Supply.kicad_sch]
2024-10-25 added Arduino FW for completeness
